cygnus666/Circuit-Sword/Home.md

# Circuit Sword Guide
Welcome to the Circuit Sword wiki! This wiki provides information on how to set up the Circuit Sword. There is also an FAQ page for troubleshooting.

## [How to set up the Circuit Sword](wiki/How-to-set-up-the-Circuit-Sword)
## [Circuit Sword FAQ](wiki/Circuit-Sword-FAQ)
