cygnus666/Circuit-Sword/files/CS_ORIGINAL_POWERBOARD_v1.1c.dxf

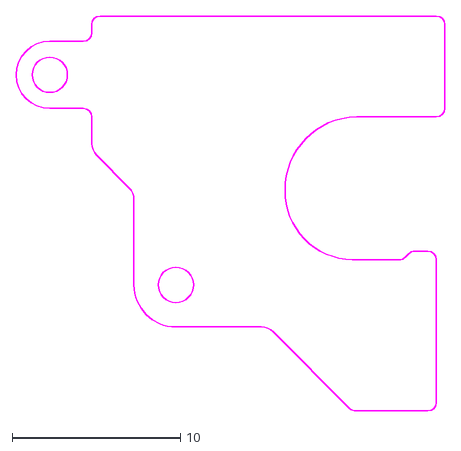
[picture p1: CAD file, 2018-06-30]
files/CS_ORIGINAL_POWERBOARD_v1.1c.dxf
25.5 x 23.5
