cygnus666/Circuit-Sword/files/CS_ORIGINAL_BACK_V1.1c.dxf

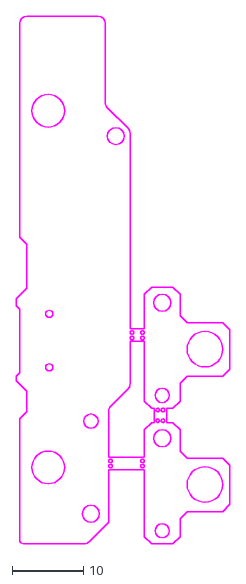
[picture p2: CAD file, 2018-06-30]
files/CS_ORIGINAL_BACK_V1.1c.dxf
30.0 x 74.0
