cygnus666/Circuit-Sword/files/CS_ORIGINAL_BACKBUTTONS_V1.0c.dxf

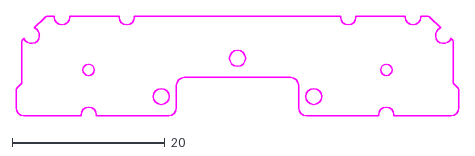
[picture p3: CAD file, 2018-06-30]
files/CS_ORIGINAL_BACKBUTTONS_V1.0c.dxf
58.0 x 13.0
