cygnus666/Circuit-Sword/files/CS_ORIGINAL_V1.3a.dxf

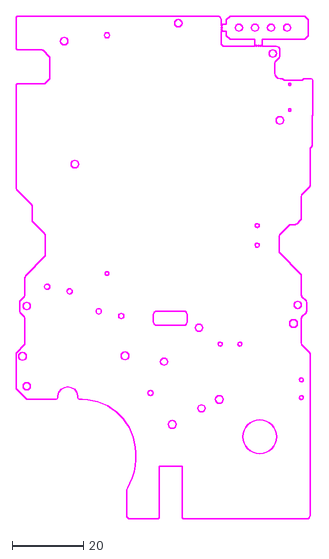
[picture p4: CAD file, 2018-06-30]
files/CS_ORIGINAL_V1.3a.dxf
83.3 x 141.0
