cygnus666/Circuit-Sword/How-to-set-up-the-Circuit-Sword.md

_Click_ ⯈ _to expand_

<details>
<summary>1. Plug a USB C cable into the Circuit Sword and check that the "PG" LED comes on
</summary>
<br />
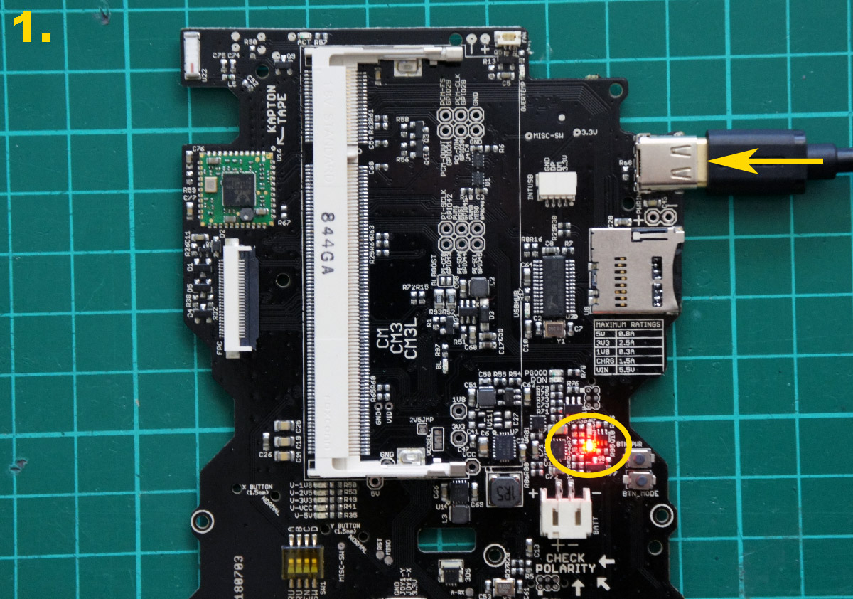
[picture p5: images/CS/1.jpg]

</details>

<br />

<details>
<summary>2. Hold down the "power" button and check that the status LEDs come on
</summary>
<br />
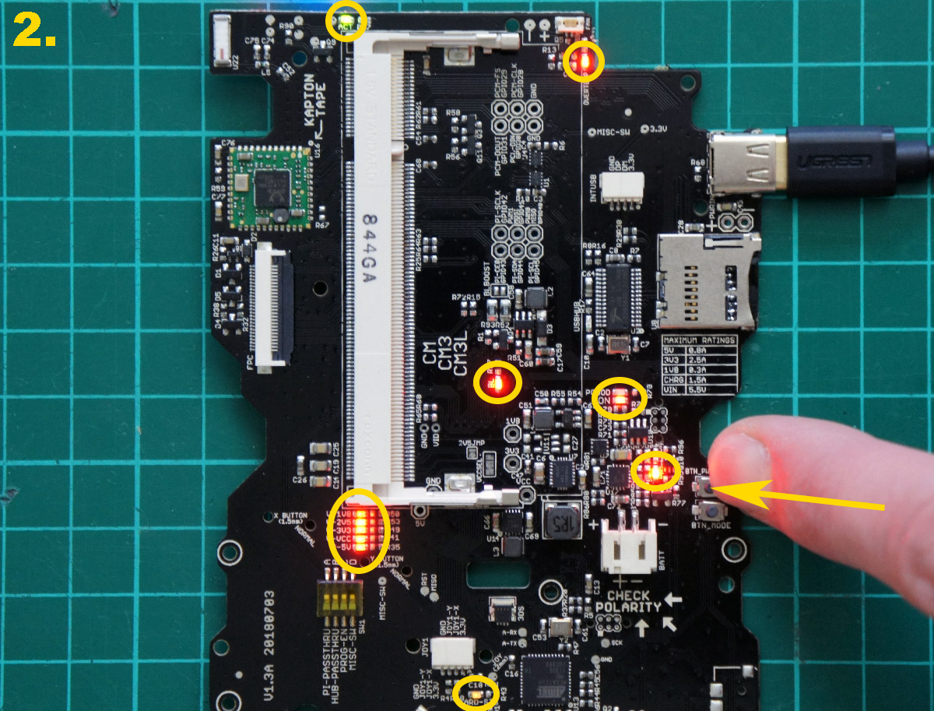
[picture p6: images/CS/2.jpg]

</details>

<br />

<details>
<summary>3. Unplug the USB C cable then plug in the battery (WARNING: USING A CONNECTOR WITH THE WRONG PIN-OUT WILL BREAK THE CIRCUIT SWORD)
</summary>
<br />
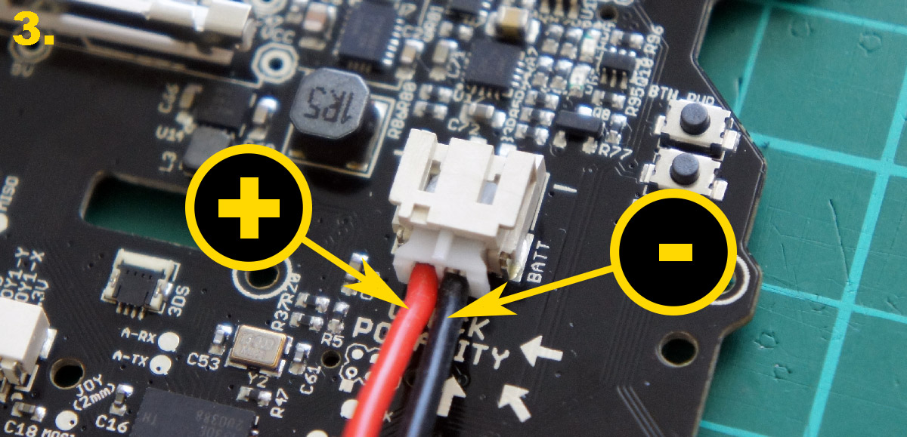
[picture p7: images/CS/3.jpg]

</details>

<br />

<details>
<summary>4. Hold down the "power" button and check that the status LEDs come on
</summary>
<br />
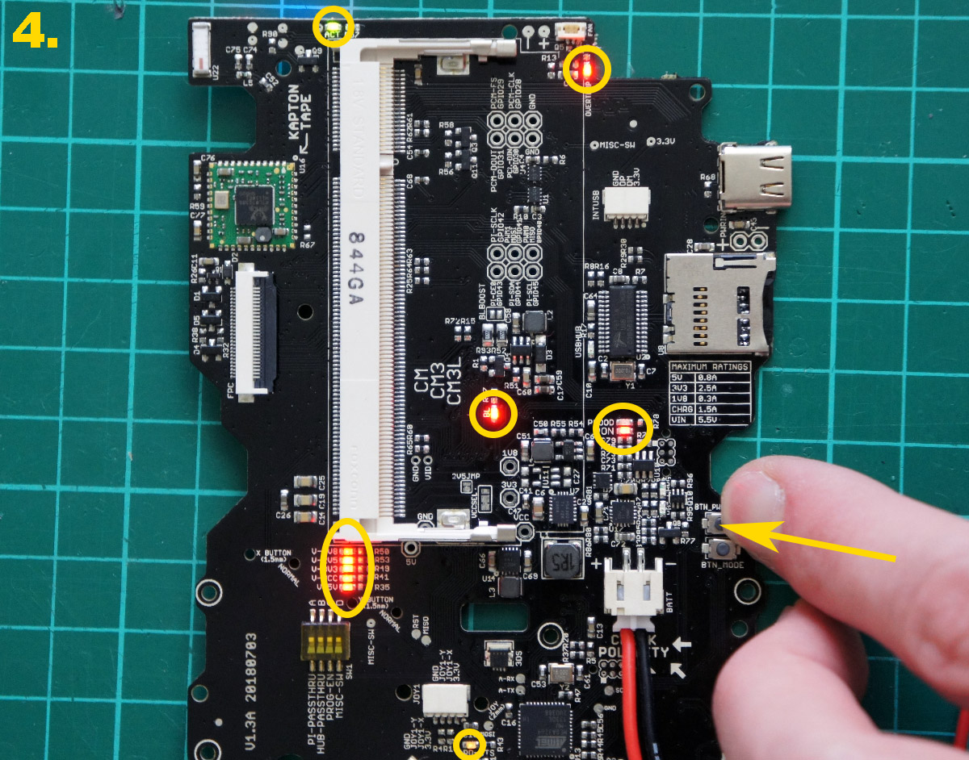
[picture p8: images/CS/4.jpg]

</details>

<br />

<details>
<summary>5. Plug in the USB C cable and check that the "CHRG" and "PG" LEDs come on
</summary>
<br />
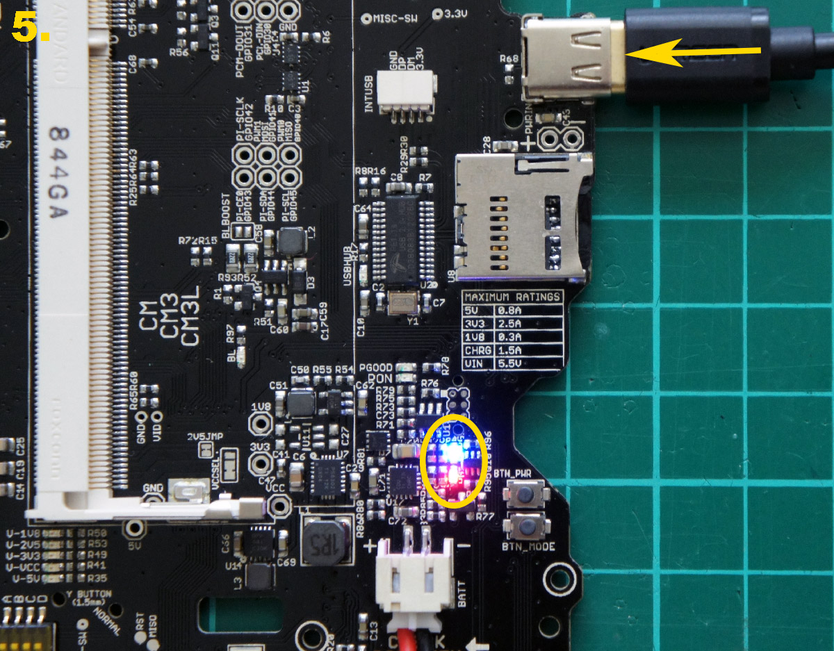
[picture p9: images/CS/5.jpg]

</details>

<br />

<details>
<summary>6. Unplug the USB C cable and battery, then plug in the Add-on board and power switch board (NOTE: INSERT THE FPC CABLE BLUE-SIDE UP). Check that the power switch is "OFF"
</summary>
<br />
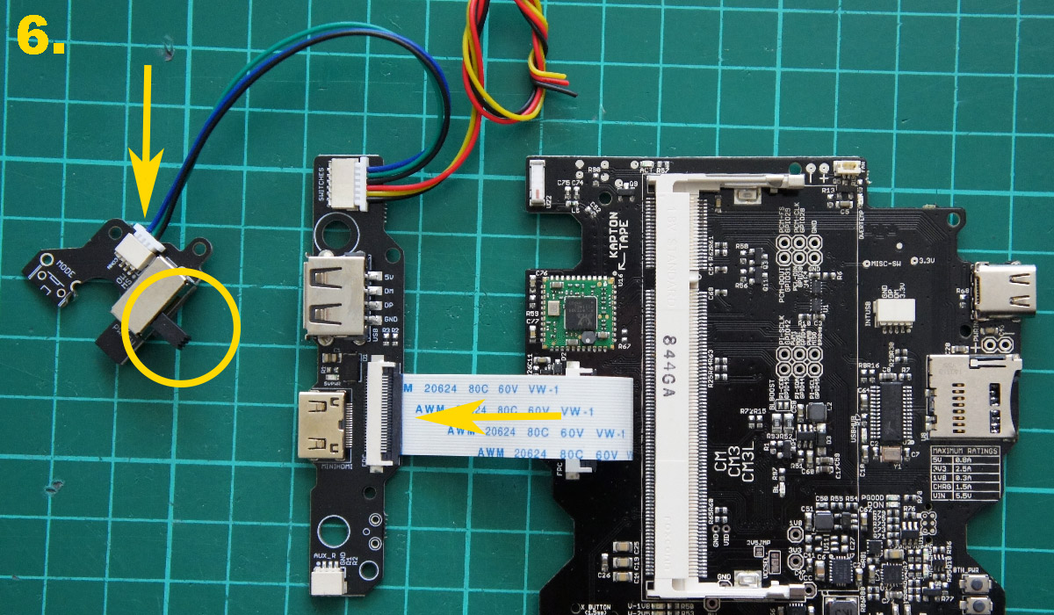
[picture p10: images/CS/6.jpg]

</details>

<br />

<details>
<summary>7. Plug in the battery then the USB C cable. Turn the power switch "ON" and check that the status LEDs come on
</summary>
<br />
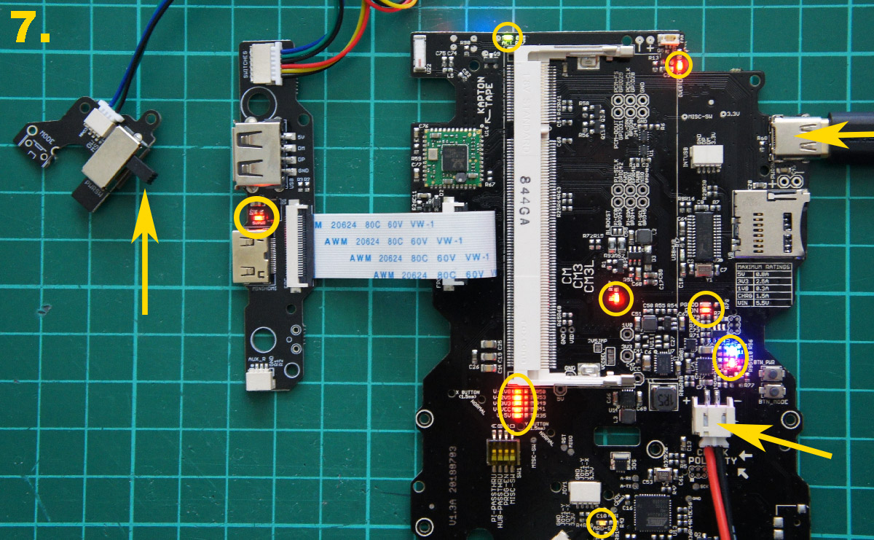
[picture p11: images/CS/7.jpg]

</details>

<br />

<details>
<summary>8. Cover the Wi-Fi module using 3 layers of Kapton tape
</summary>
<br />
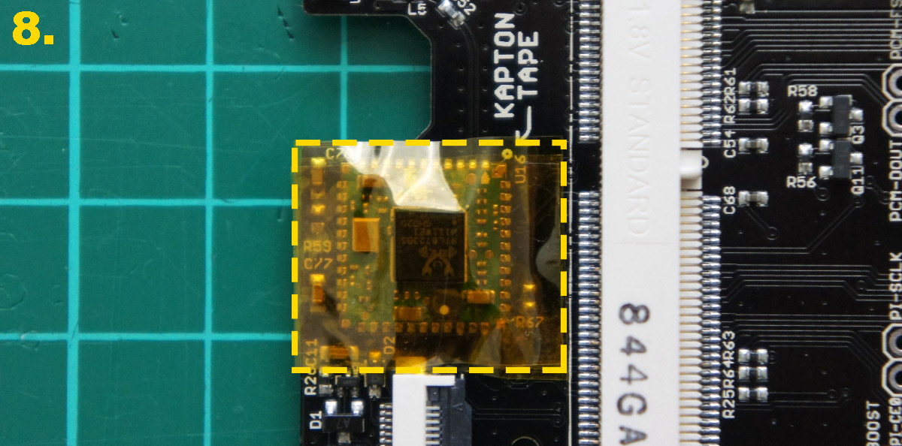
[picture p12: images/CS/8.jpg]

</details>

<br />

<details>
<summary>9. Insert the Raspberry Pi Compute Module 3 Lite at a 45° angle then carefully click it into place
</summary>
<br />
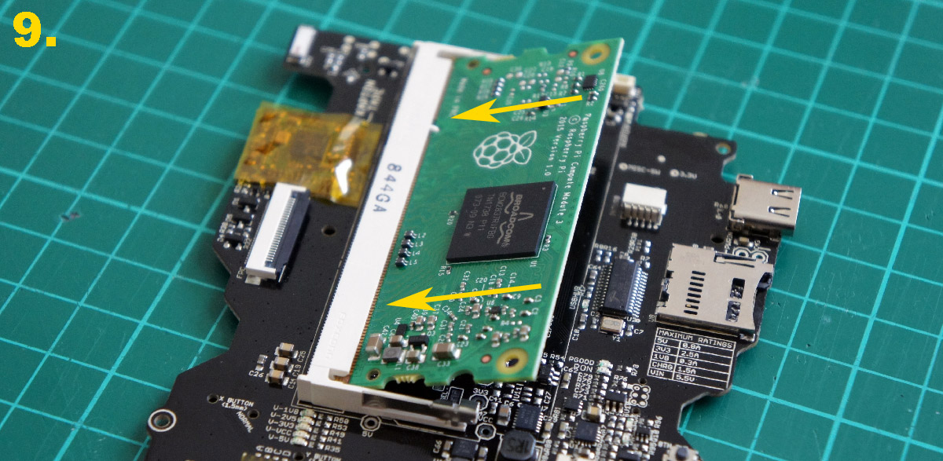
[picture p13: images/CS/9.jpg]

</details>

<br />

<details>
<summary>10. Plug in the LCD
</summary>
<br />
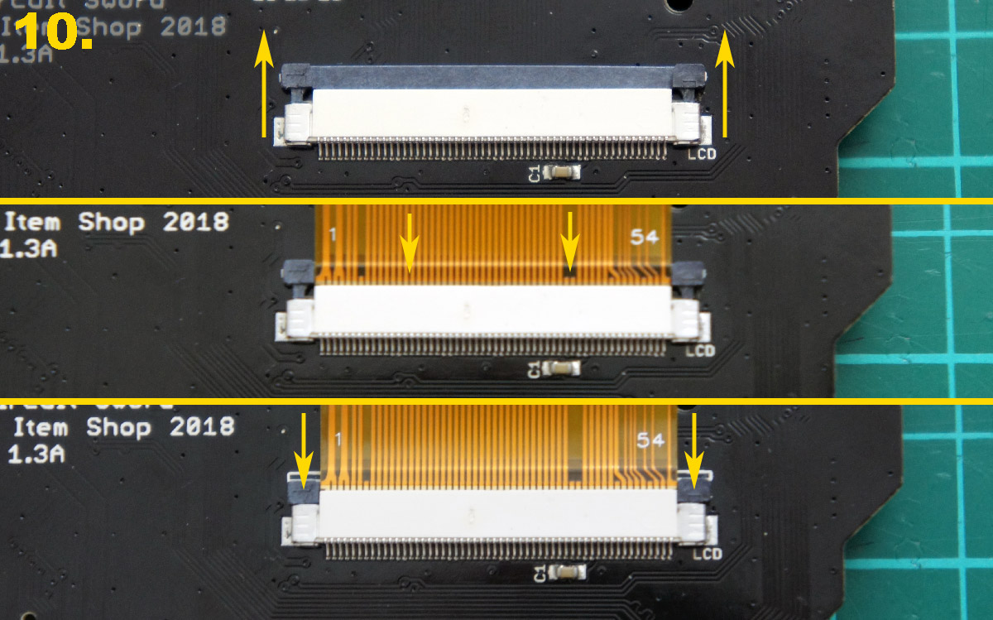
[picture p14: images/CS/10.jpg]

</details>

<br />

<details>
<summary>11. Download the Circuit Sword Software then use Win32 Disk Imager to write it to an SD card. Open the `config-cs.txt` file using "Notepad++" then change `#MODE=TESTER` to `MODE=TESTER`
</summary>
<br />

[__☆ CIRCUIT SWORD SOFTWARE ☆__](https://github.com/kiteretro/Circuit-Sword/releases)

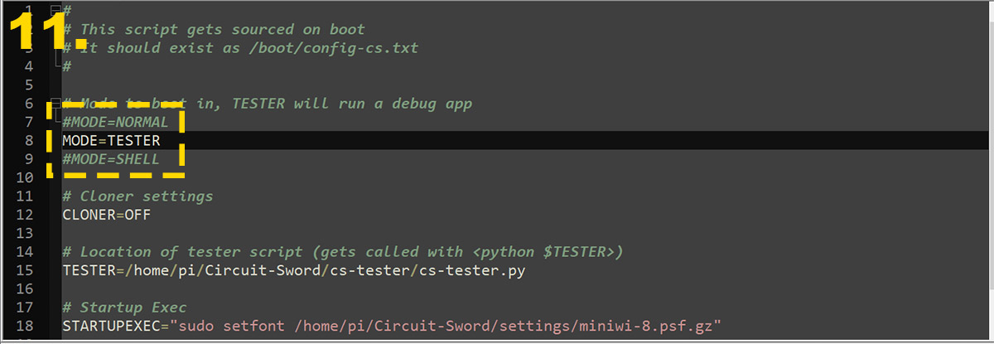
[picture p15: images/CS/11.jpg]

</details>

<br />

<details>
<summary>12. Insert the SD card then turn the power switch "ON". Once fully booted check that all of the tests have passed
</summary>
<br />
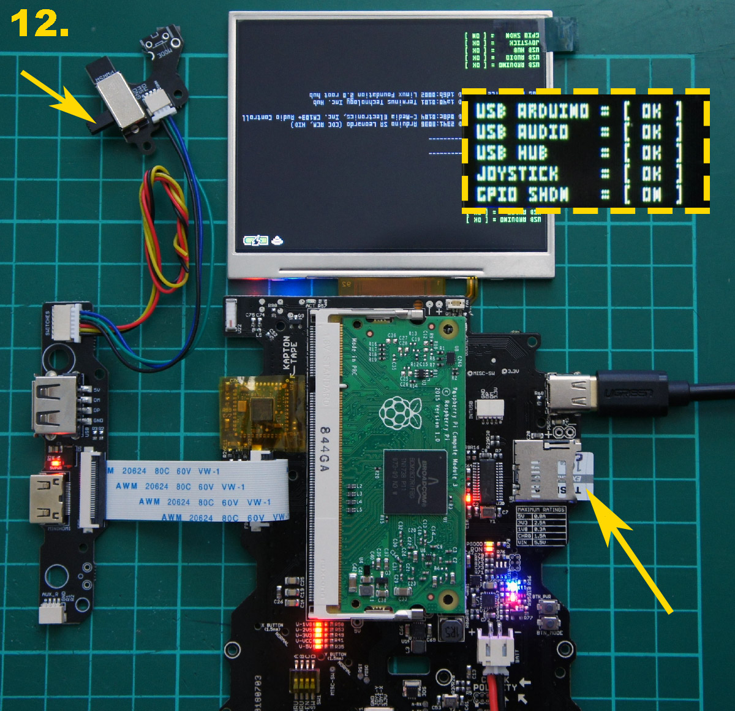
[picture p16: images/CS/12.jpg]

</details>

<br />

<details>
<summary>13. Hold down the "mode" button and wait for the configuration menu to appear
</summary>
<br />
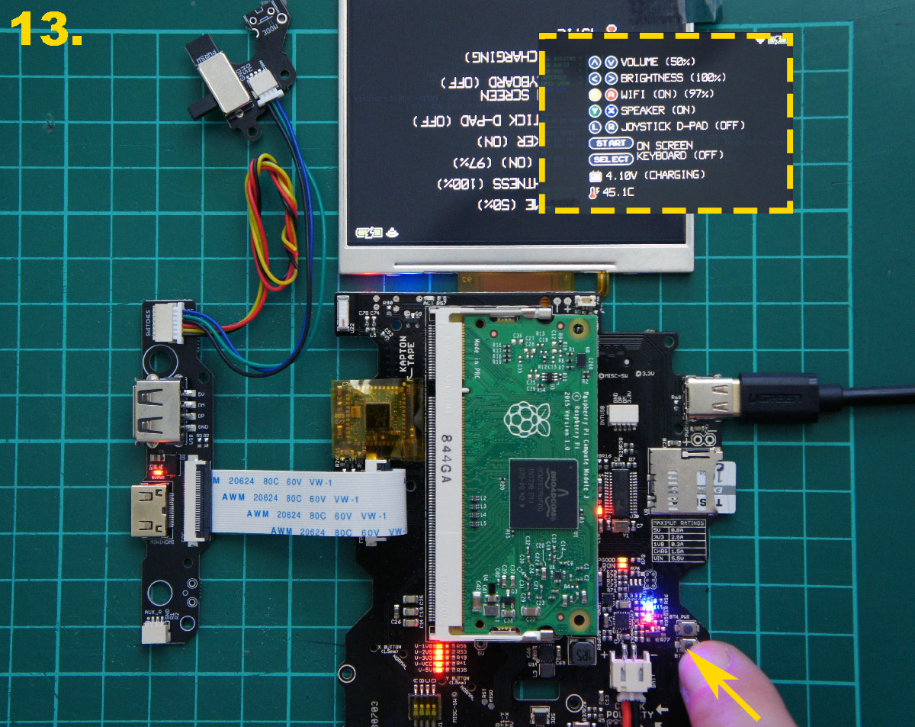
[picture p17: images/CS/13.jpg]

</details>

<br />

<details>
<summary>14. Turn the power switch "OFF" and wait for the Circuit Sword to shut down
</summary>
<br />
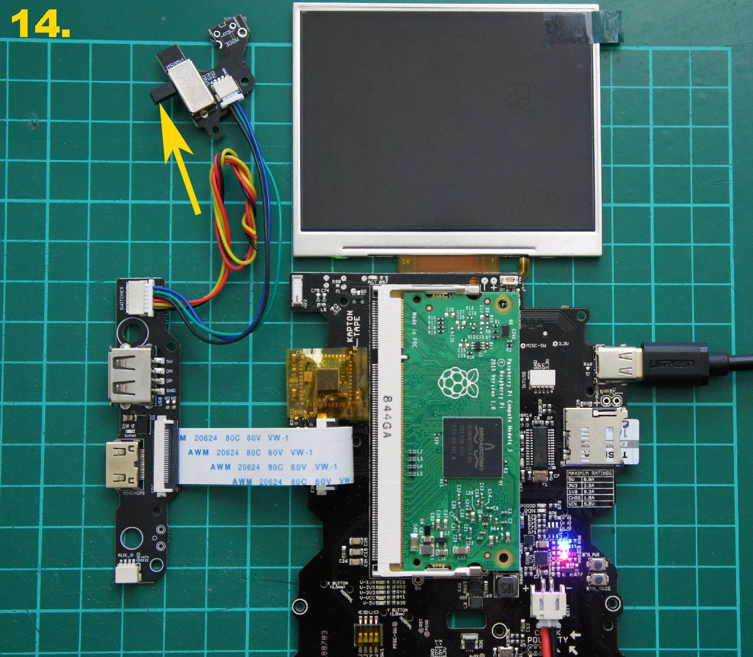
[picture p18: images/CS/14.jpg]

</details>

<br />

<details>
<summary>15. Solder an additional "mode" button to the power switch board then trim the pins
</summary>
<br />
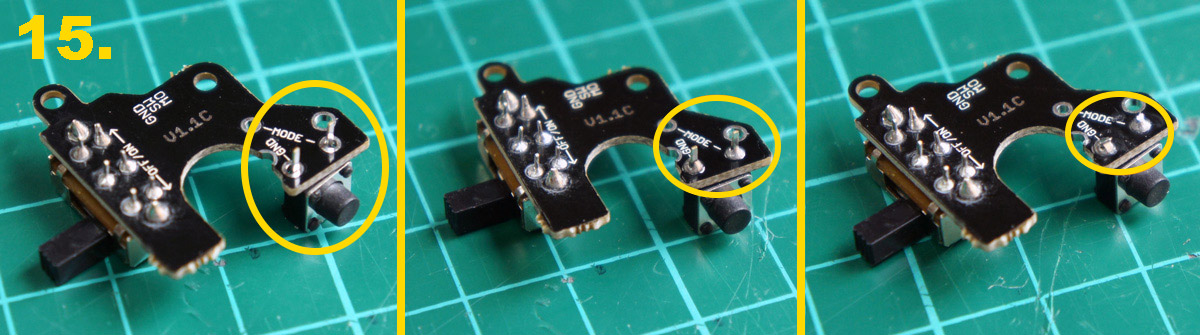
[picture p19: images/CS/15.jpg]

</details>

<br />

<details>
<summary>16. Solder the spacers to the Add-on board one on top of the other
</summary>
<br />
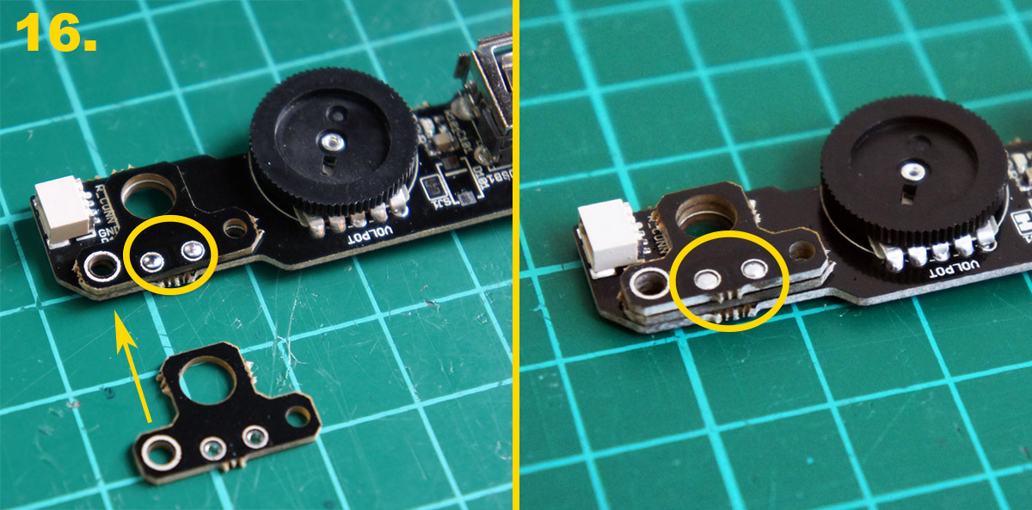
[picture p20: images/CS/16.jpg]

</details>

<br />

<details>
<summary>17. Stick the heatsink to the Raspberry Pi Compute Module 3 Lite
</summary>
<br />
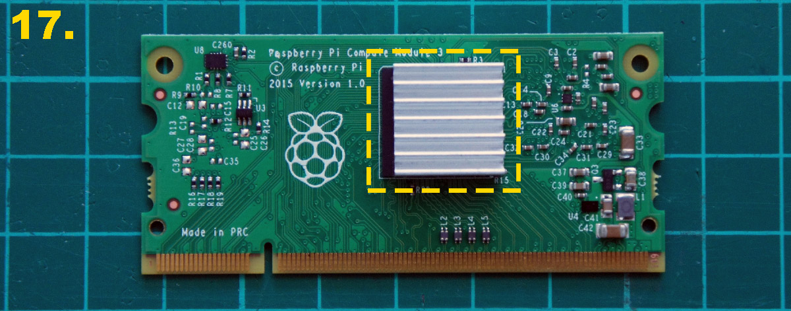
[picture p21: images/CS/17.jpg]

</details>

<br />

<details>
<summary>18. Stick the fan to the Raspberry Pi Compute Module 3 Lite using double-sided foam tape
</summary>
<br />
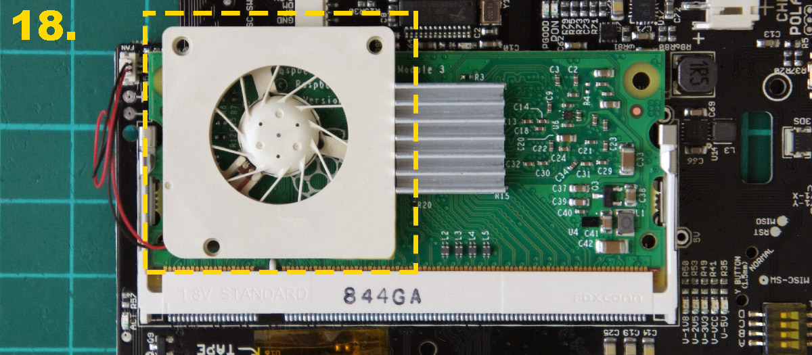
[picture p22: images/CS/18.jpg]

</details>

<br />

<details>
<summary>19. Solder the 2-pin cable to the speaker then plug in the speaker
</summary>
<br />
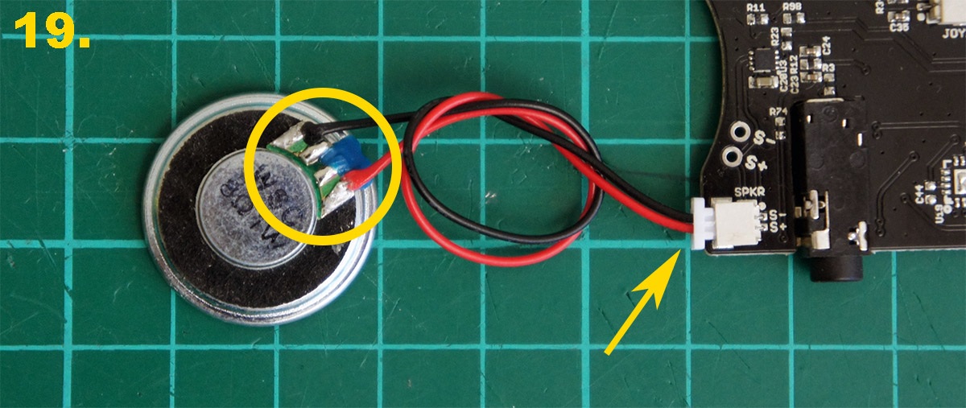
[picture p23: images/CS/19.jpg]

</details>
