cygnus666/Circuit-Sword/(commit log)

2018-02-03 Created Troubleshooting (LCD/Power/USB/Software) (markdown)
2018-02-04 Created Mode Button Shortcut Keys (markdown)
2018-02-04 Created Configuration Switches (markdown)
2018-02-04 Created Circuit Sword Original V1.1E (markdown)
2018-02-04 Created Circuit Sword Original - Electronics Guide (markdown)
2018-02-04 Updated Circuit Sword Original V1.1E (markdown)
2018-02-04 Updated Circuit Sword Original Electronics Guide (markdown)
2018-02-04 Created Updating Arduino (button controller) Firmware (markdown)
2018-02-05 Updated Updating Arduino (button controller) Firmware (markdown)
2018-02-05 Created Fan and Heatsink (markdown)
2018-02-06 Created GB Original Case Mod Guide (asciidoc)
2018-02-06 switched edit mode to "MarkDown"
2018-02-07 Updated GB Original Case Mod Guide (asciidoc => markdown)
2018-02-07 Updated GB Original Case Mod Guide (markdown)
2018-02-09 Updated Mode Button Shortcut Keys (markdown)
2018-02-14 doc: Added how to configure input for PICO-8
2018-02-14 doc: Added Confiture input for PICO-8 in Tweaks
2018-02-14 Updated Configure input for PICO 8 (markdown)
2018-02-24 Updated Troubleshooting (LCD Power USB Software) (markdown)
2018-06-03 Created Configuring the software without flashing the arduino (markdown)
2018-06-03 Updated Configuring the software without flashing the arduino (markdown)
2018-06-08 Updated Original Case Mod Guide (markdown)
2018-06-12 Updated Fan and Heatsink (markdown)
2018-06-20 Updated CS Assembly (markdown)
2018-06-30 DXF file
    [CS_ORIGINAL_V1.3a.dxf]
2018-06-30 Added the other parts as DXF
    [CS_ORIGINAL_BACKBUTTONS_V1.0c.dxf, CS_ORIGINAL_BACK_V1.1c.dxf, CS_ORIGINAL_POWERBOARD_v1.1c.dxf]
2019-01-05 Updated Case Mod Guide (markdown)
2019-01-08 Created How to set up the Circuit Sword (markdown)
2019-01-08 Updated How to set up the Circuit Sword (markdown)
2019-01-09 Destroyed Mode Button Shortcut Keys (markdown)
2019-01-09 Destroyed Configuration Switches (markdown)
2019-01-09 Destroyed Troubleshooting (LCD Power USB Software) (markdown)
2019-01-09 Destroyed Configuring the software without flashing the arduino (markdown)
2019-01-09 Destroyed Updating Arduino (button controller) Firmware (markdown)
2019-01-09 Destroyed Configure input for PICO 8 (markdown)
2019-01-09 Destroyed Circuit Sword Original V1.1E (markdown)
2019-01-09 Destroyed Circuit Sword Original Electronics Guide (markdown)
2019-01-09 Destroyed Fan and Heatsink (markdown)
2019-01-09 Destroyed CS Assembly (markdown)
2019-01-09 Destroyed GB Original Case Mod Guide (markdown)
2019-01-11 Created Circuit Sword FAQ (markdown)
2019-01-11 Updated Circuit Sword FAQ (markdown)
